currentleak/243-436-PCB-Support-STM32F407/README.md

# 243-436-PCB-Support-STM32F407

## PCB Support pour kit de développement STM32F407 Discovery 1

- Interface LCD 5V -- KS0108 ou LCD 12864
- Interface MikroBus (2)
- Interface PMOD -- GPIO -- I2C -- SPI -- UART
- Entrée Alimentation externe 5V
- Connecteur USB-C : Entrée 5V et USB à UART
