currentleak/243-436-PCB-Support-STM32F407/PDF/Report Board Stack.PDF

Layer | Board Layer Stack | Name | Material | Thickness Constant
1 | | Top Overlay | | 0mm
2 | | Top Solder | SM-001 | 0.0254mm | 4
3 | | Top Surface Finish | PbSn | 0.02mm
4 | | Top Layer | CF-004 | 0.035mm
5 | | Dielectric 1 | PP-017 | 0.12954mm | 4.3
6 | | Dielectric 2 | PP-017 | 0.12954mm | 4.3
7 | | Int1 (GND) | CF-004 | 0.035mm
8 | | Dielectric 3 | Core-039 | 0.7112mm | 4.8
9 | | Int2 (PWR) | CF-004 | 0.035mm
10 | | Dielectric 4 | PP-017 | 0.12954mm | 4.3
11 | | Dielectric 5 | PP-017 | 0.12954mm | 4.3
12 | | Bottom Layer | CF-004 | 0.035mm
13 | | Bottom Surface Finish | PbSn | 0.02mm
14 | | Bottom Solder | SM-001 | 0.0254mm | 4
15 | | Bottom Overlay | | 0mm
| Height : 1.46016mm

# Board Stack Report

Stack Up | Layer Stack
