currentleak/243-436-PCB-Support-STM32F407/PDF/Electrical Rules Check.PDF

### Electrical Rules Check Report

Class | Document | Message Successful Compile for 243-436_PCB-Support-STM32F407.PrjPcb
samedi 28 févr. 2026 2:19:12 PM | Page 1 of 1
