currentleak/243-436-PCB-Support-STM32F407/Generate Files/BOM/243-436_PCB-Support-STM32F407.xlsx

LibRef | Comment | Quantity | Designator | Description | CEGEP | Code CEGEP | Localisation | Manufacturer 1 | Manufacturer Part Number 1 | Supplier 1 | Supplier Part Number 1 | Supplier 2 | Supplier Part Number 2 | Mounting Technology
CAP003 | Cap 4.7uF 0805 | 14 | C1, C5, C7, C12, C14, C16A, C16B, C17A, C17B, C18, C19, C20, C21, C25 | Capacitor type 1 | KCOND02SM |  |  | Taiyo Yuden | TMK212AB7475KG-T | LCSC | C163186 |  |  | SMT
CAP001 | Cap 100nF 0402 | 12 | C2, C3, C6, C8, C11, C13, C15, C22, C23A, C23B, C24A, C24B | Capacitor type 1 | KCOND01SM |  |  | Taiyo Yuden | UMK105B7104KV-FR | LCSC | C2167491 |  |  | SMT
CAP005 | Cap 100uF 1206 | 1 | C4 | Capacitor type 1 | KCOND04SM |  |  | Murata | GRM31CR61A107MEA8L | LCSC | C883598 |  |  | SMT
CAP020 | CAP CER 10uF 25V X5R 0805 | 2 | C9, C10 | Capacitor type 1 |  |  |  | Samsung | CL21A106KAYNNNE | LCSC | C15850 |  |  | SMT
D_BAT60 | BAT60JFILM | 5 | D1, D2, D3, D4, D5 | DIODE SCHOTTKY 10V 3A SOD323 |  |  |  | ST | BAT60JFILM | LCSC | C133103 |  |  | SMT
CONN-DC-JACK-2MM5 | 694106301002 | 1 | J1 | DC Barrel Connector 2.5mm |  |  |  | XKB Connection | DC-005-5A-2.5 | LCSC | C381115 |  |  | TH
CONN-100MIL-HDR-01X02 | 61300211121 | 1 | J2 | CONN HEADER 2POS 100MIL |  |  |  | Megastar | ZX-PZ2.54-1-2PZZ | LCSC | C7501260 |  |  | TH
IND001 | Ind 1UH 2.75A 51mOHM SMD | 1 | L1 | Inductor type 1 | KPTSO09 |  |  | Murata Electronics | LQH3NPN1R0MMEL | LCSC | C703777 |  |  | SMT
CONN-100MIL-SKT-01X06_RA | PPTC061LGBN-RC | 1 | P1 | CONN SOCKET 6pos 100mils Right Angle |  |  |  | Megastar | ZX-PM2.54-1-6PWZ | LCSC | C49326178 | Digikey | S5442-ND | TH
CONN-100MIL-SKT-01X02 | ZX-PM2.54-1-2PY | 2 | P2, P3 | CONN SOCKET 2pins single row , 100mils TH |  |  |  | Megastar | ZX-PM2.54-1-2PY | LCSC | C7499322 |  |  | TH
CONN-100MIL-SKT-02X25 | ZX-PM2.54-2-25PY | 2 | P4, P5 | CONN SOCKET 2x25POS, Dual row 100MIL |  |  |  | Megastar | ZX-PM2.54-2-25PY | LCSC | C7499355 | Digikey | S9201-ND | TH
CONN-USB-C-16POS | USB4085-GF-A | 1 | P6 | CONN RCPT USB2.0 TYPE C RA - TH |  | ? (R13-B182) |  | Global Connector Technology | USB4085-GF-A | LCSC | C7095263 | Digikey | 2073-USB4085-GF-ACT-ND | TH
CONN-5MM-2POS-TERM-BLOCK | ZX-DG28V-5.0-2P | 1 | P7 | CONN TERM BLOCK 2POS 5mm pitch |  | CONWECO0002 |  | Megastar | ZX-DG28V-5.0-2P | LCSC | C49022995 |  |  | TH
CONN-100MIL-SKT-01X06 | ZX-PM2.54-1-6PY | 5 | P9, P10, P11, P12, P13 | CONN SOCKET 6pos 100mils |  |  |  | Megastar | ZX-PM2.54-1-6PY | LCSC | C7499326 |  |  | TH
CONN-5MM-3POS-TERM-BLOCK | ZX-DG28V-5.0-3P | 1 | P14 | CONN TERM BLOCK 3POS 5mm pitch |  | CONWECO0003 |  | Megastar | ZX-DG28V-5.0-3P | LCSC | ZX-DG28V-5.0-3P |  |  | TH
CONN-100MIL-SKT-01X08 | ZX-PM2.54-1-8PY | 4 | P14A, P14B, P15A, P15B | CONN SOCKET 8pos 100mils |  |  |  | Megastar | ZX-PM2.54-1-8PY | LCSC | C7499328 |  |  | TH
CONN-100MIL-SKT-01X20 | ESQ-120-14-G-S | 1 | P15 | CONN SOCKET 20POS 2.54MM |  | KCONDIV0053 | R13-B035 | Megastar | ZX-PM2.54-1-20PY | LCSC | C7499336 |  |  | TH
RES005 | Res 0R 0402 | 6 | R3, R4, R8, R10, R11, R12 | Resistor type 1 |  |  |  | Yageo | RC0402JR-070RL | LCSC | C60485 |  |  | SMT
RES010 | Res 5k1 1% 0402 | 3 | R7, R13, R14 | Resistor type 1 |  |  |  | Panasonic | ERJ-2RKF5101X | LCSC | C25905 |  |  | SMT
RES003 | Res 10k 1% 0402 | 4 | R9, R18, R19, R21 | Resistor type 1 |  |  |  | Vishay | CR0402F1002T1LF | Digikey | 541-10.0KLCT-ND |  |  | SMT
RES011 | Res 91k 1% 0402 | 1 | R16 | Resistor type 1 |  | RES91KSM |  | Yageo | RC0402FR-0791KL | LCSC | C327323 |  |  | SMT
RES012 | Res 511k 1% 0402 | 1 | R17 | Resistor type 1 |  | RES511KSM |  | Yageo | RC0402FR-07511KL | LCSC | C163461 |  |  | SMT
RES014 | Res 120R 1206 | 1 | R20 | Resistor type 1 | RESI0043SMT |  |  | Yageo | RC1206FR-07120RL | LCSC | C114928 | Digikey | P120ECT-ND | SMT
RES020 | Res 20R 1206 | 1 | R22 | Resistor type 1 | RESI00020SMT |  |  | Yageo | RC1206FR-0720RL | LCSC | C114941 |  |  | SMT
RES026 | Res 49k9 1% 0402 | 1 | R23 | Resistor type 1 |  |  |  | Yageo | RC0402FR-0749k9L | LCSC | C137969 |  |  | SMT
U_CH340X | CH340X | 1 | U1 | IC USB to Serial Port |  | KPTSO02 |  | WCH(Jiangsu Qin Heng) | CH340X | LCSC | C3035748 |  |  | SMT
U_TPD4E05U06 | TPD4E05U06QDQARQ1 | 1 | U2 | TVS DIODE 5.5V 14V 10USON |  |  |  | Texas Instruments | TPD4E05U06QDQARQ1 | LCSC | C81353 | Digikey | 296-40696-1-ND | SMT
U_TPS631000DRLR | TPS631000DRLR | 1 | U3 | buck-boost converter 1.5-A output current, |  |  |  | Texas Instruments | TPS631000DRLR | LCSC | C5219190 | Digikey | 296-TPS631000DRLRCT-ND | SMT
U_SN65HVD230DR | SN65HVD230DR | 1 | U4 | IC TRANSCEIVER HALF 1/1 8SOIC |  |  |  | TI | SN65HVD230DR | LCSC | C12084 |  |  | SMT
U_TXB0108PWR | TXB0108PWR | 2 | U5A, U5B | IC 8-Bit Bidirectional Voltage-Level Translator with Auto-Direction Sensing 20-Pin TSSOP (PW) |  |  |  | Texas Instruments | TXB0108PWR | LCSC | C53406 |  |  | SMT
RP-POT10K-MULTI-TURN-TOP-TH | 3296W-1-103LF | 1 | VR1 | TRIMMER 10K OHM 0.5W PC PIN TOP |  |  |  | JIERR | 3296W-1-103LF | LCSC | C49190453 | LCSC | C34846 | TH
