currentleak/243-436-PCB-Support-STM32F407/Generate Files/AutoCAD PCB/243-436_PCB-Support-STM32F407.DXF

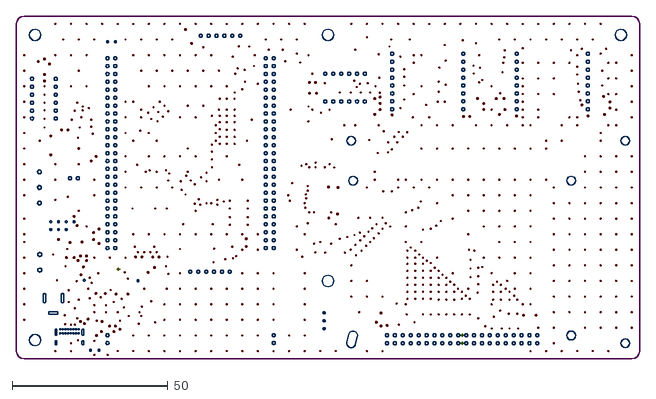
[picture p1: CAD file, 2026-02-28]
Generate Files/AutoCAD PCB/243-436_PCB-Support-STM32F407.DXF
200.0 x 110.0
