currentleak/243-436-PCB-Support-STM32F407/PDF/Schematic Prints.PDF

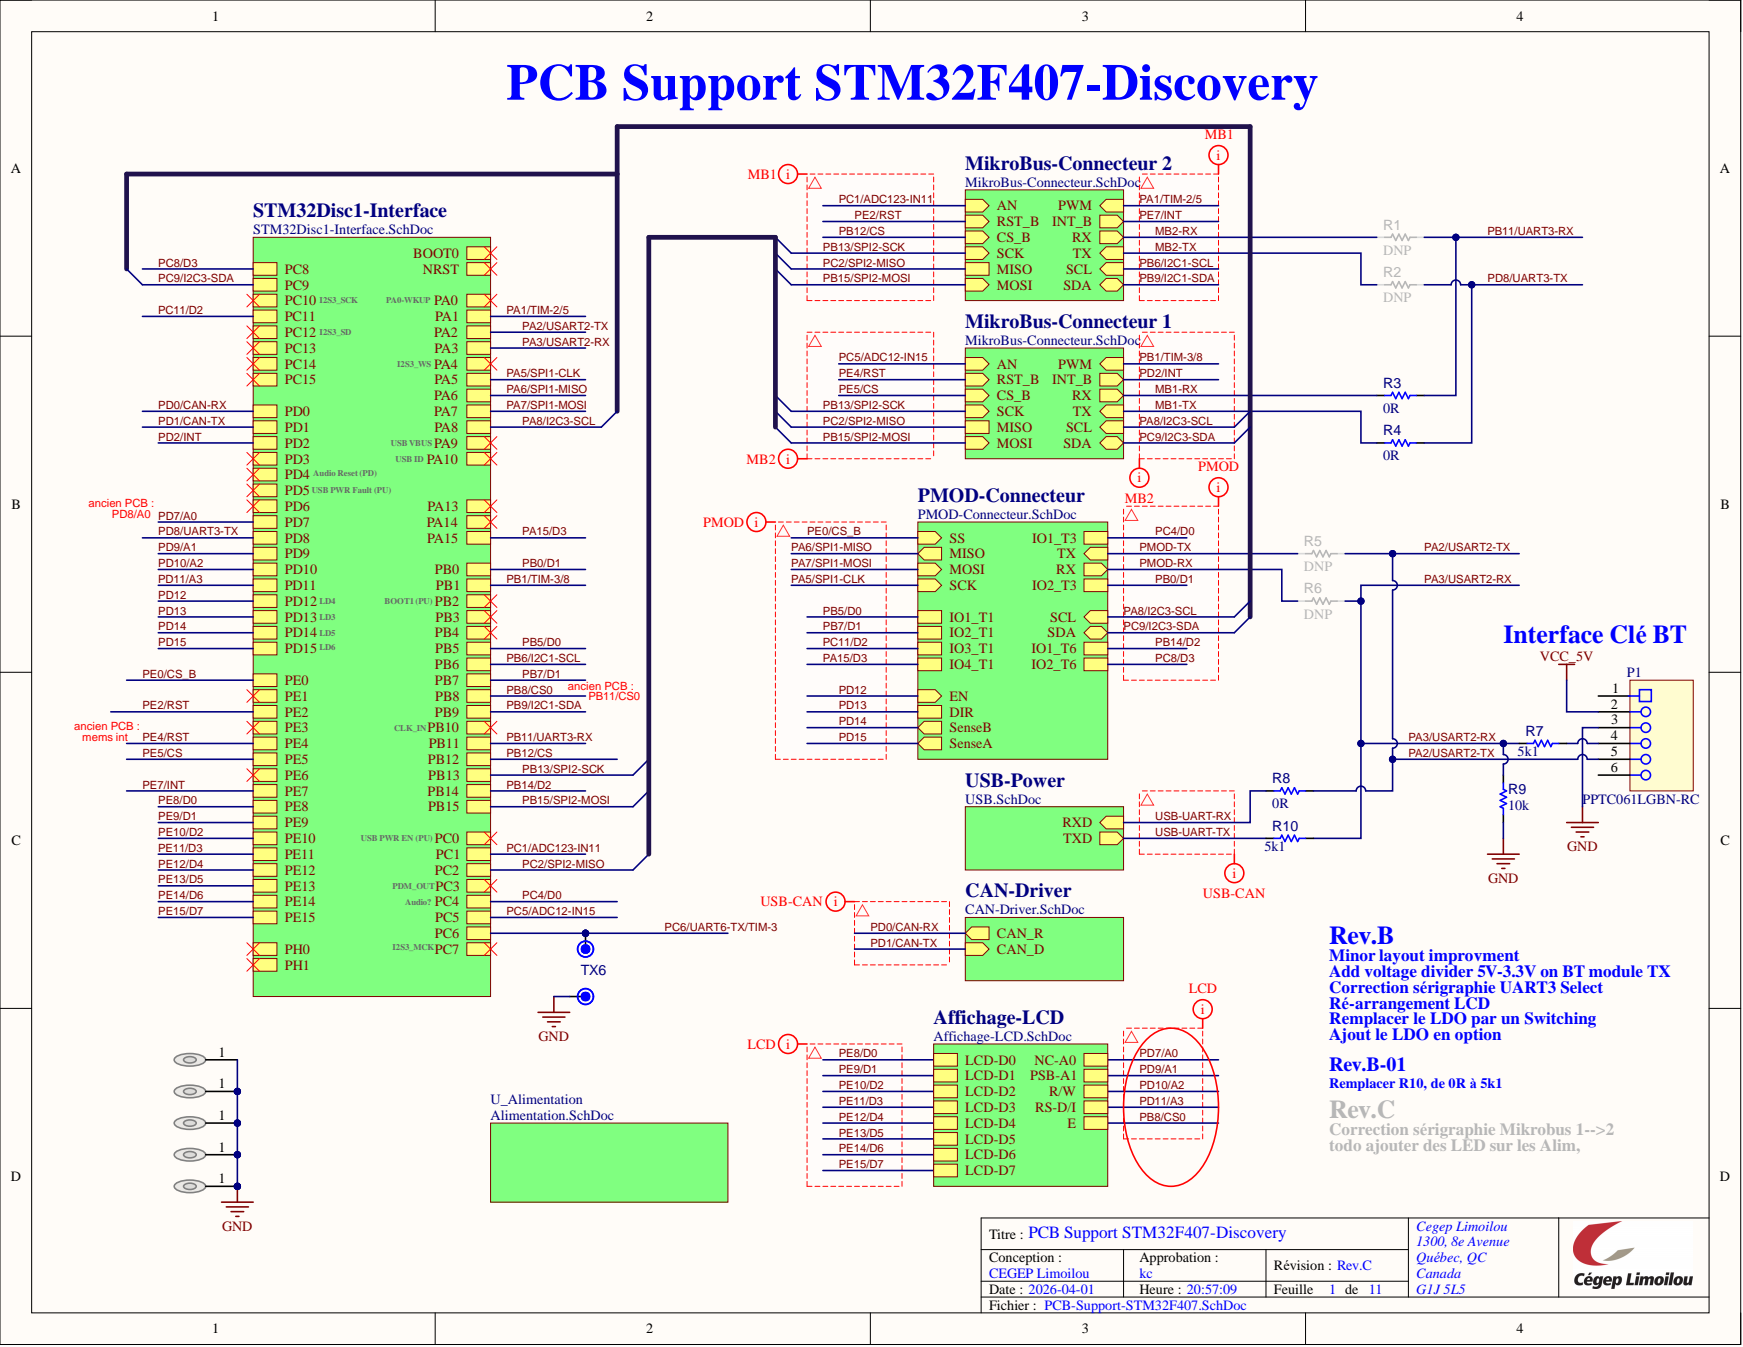
[picture p2: page 1]

PCB Support STM32F407-Discovery PA1/TIM-2/5

PE7/IN T
MB2-R X
MB2-TX
PB6/I2C1-SC L
PB9/I2C1-SD A

USB-Power USB.SchDoc

USB PWR EN (PU)

CAN-Driver CAN-Driver.SchDoc

Rev.B
Minor layout improvment
Add voltage divider 5V-3.3V on BT
Correction
é-arrangement LCD
Remplacer le LDO par un Switching
Ajout le LDO en option
Rev.B-0
Remplacer R10, de 0R
Rev.C
todo ajouter des LED sur les Alim

PD9/A 1
PD10/A 2
PD11/A 3
PB8/CS 0

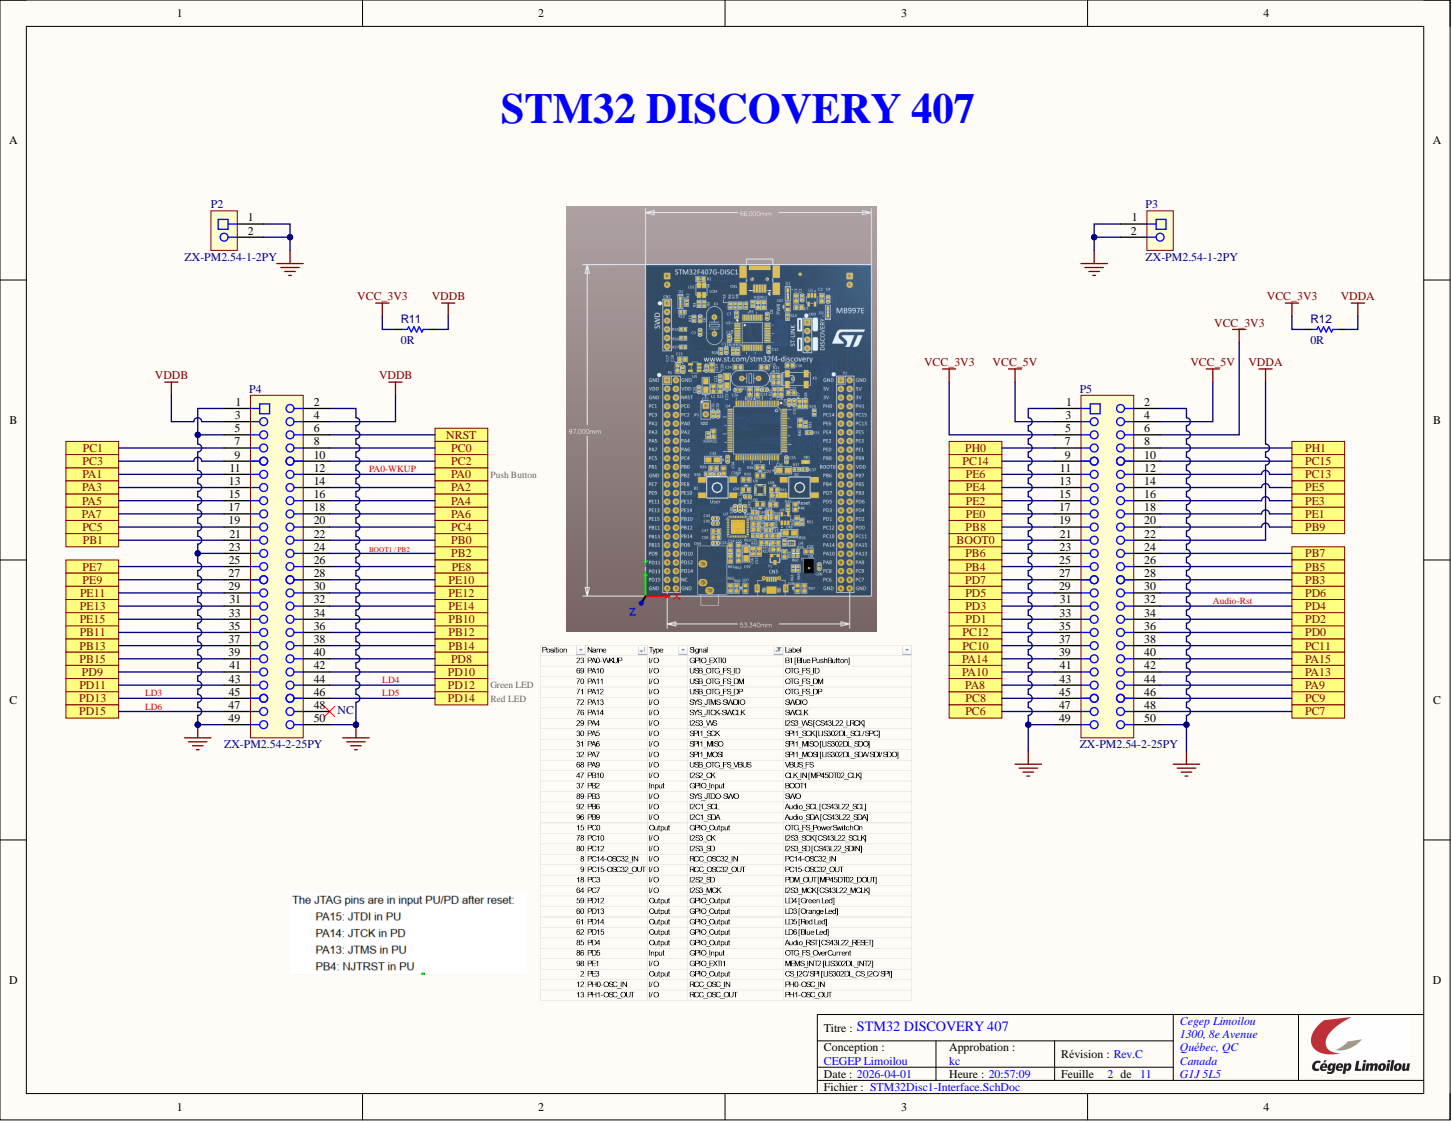
[picture p3: page 2]

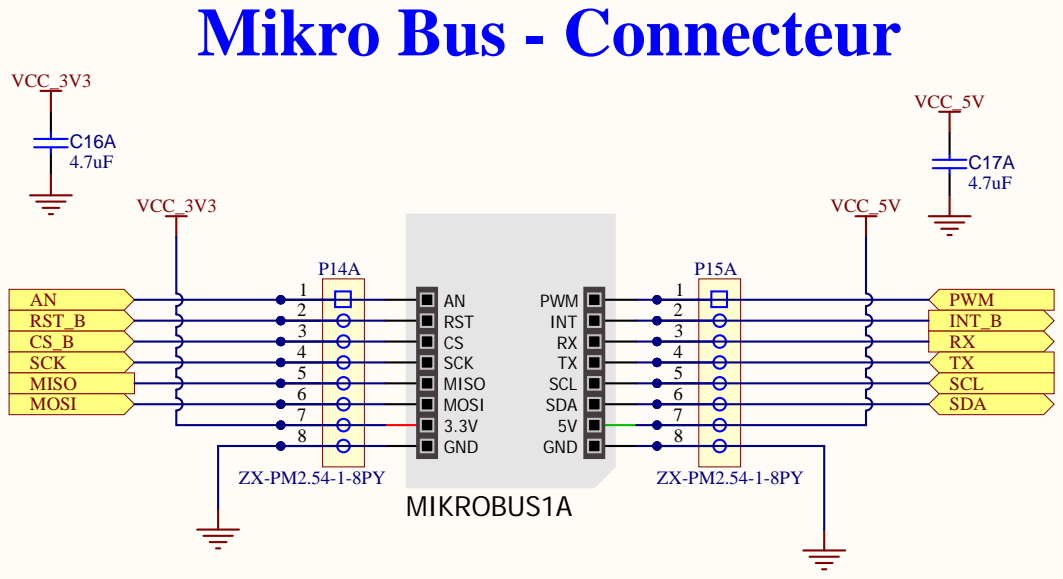
[picture p4: page 3]

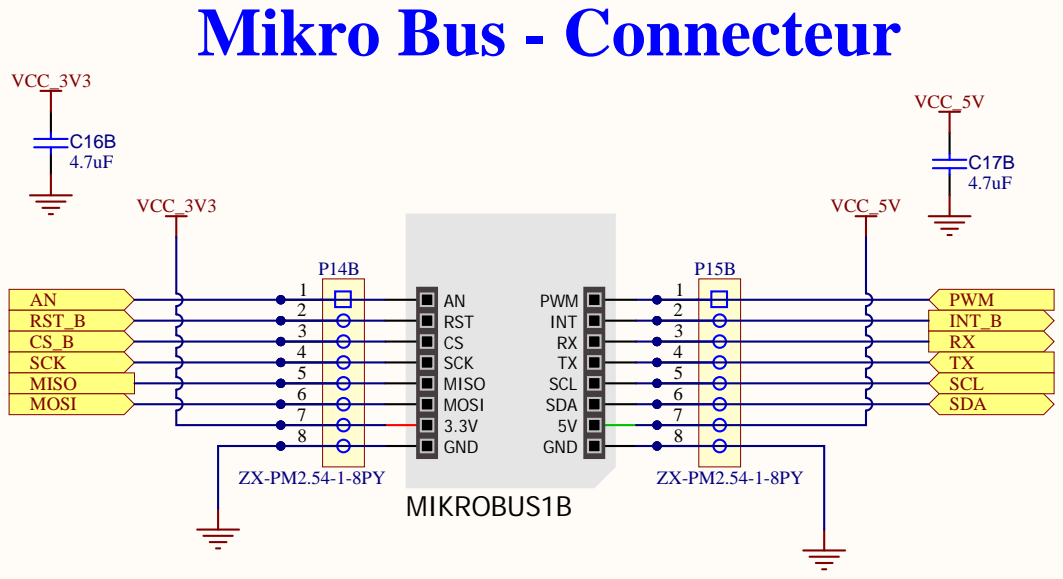
[picture p5: page 4]

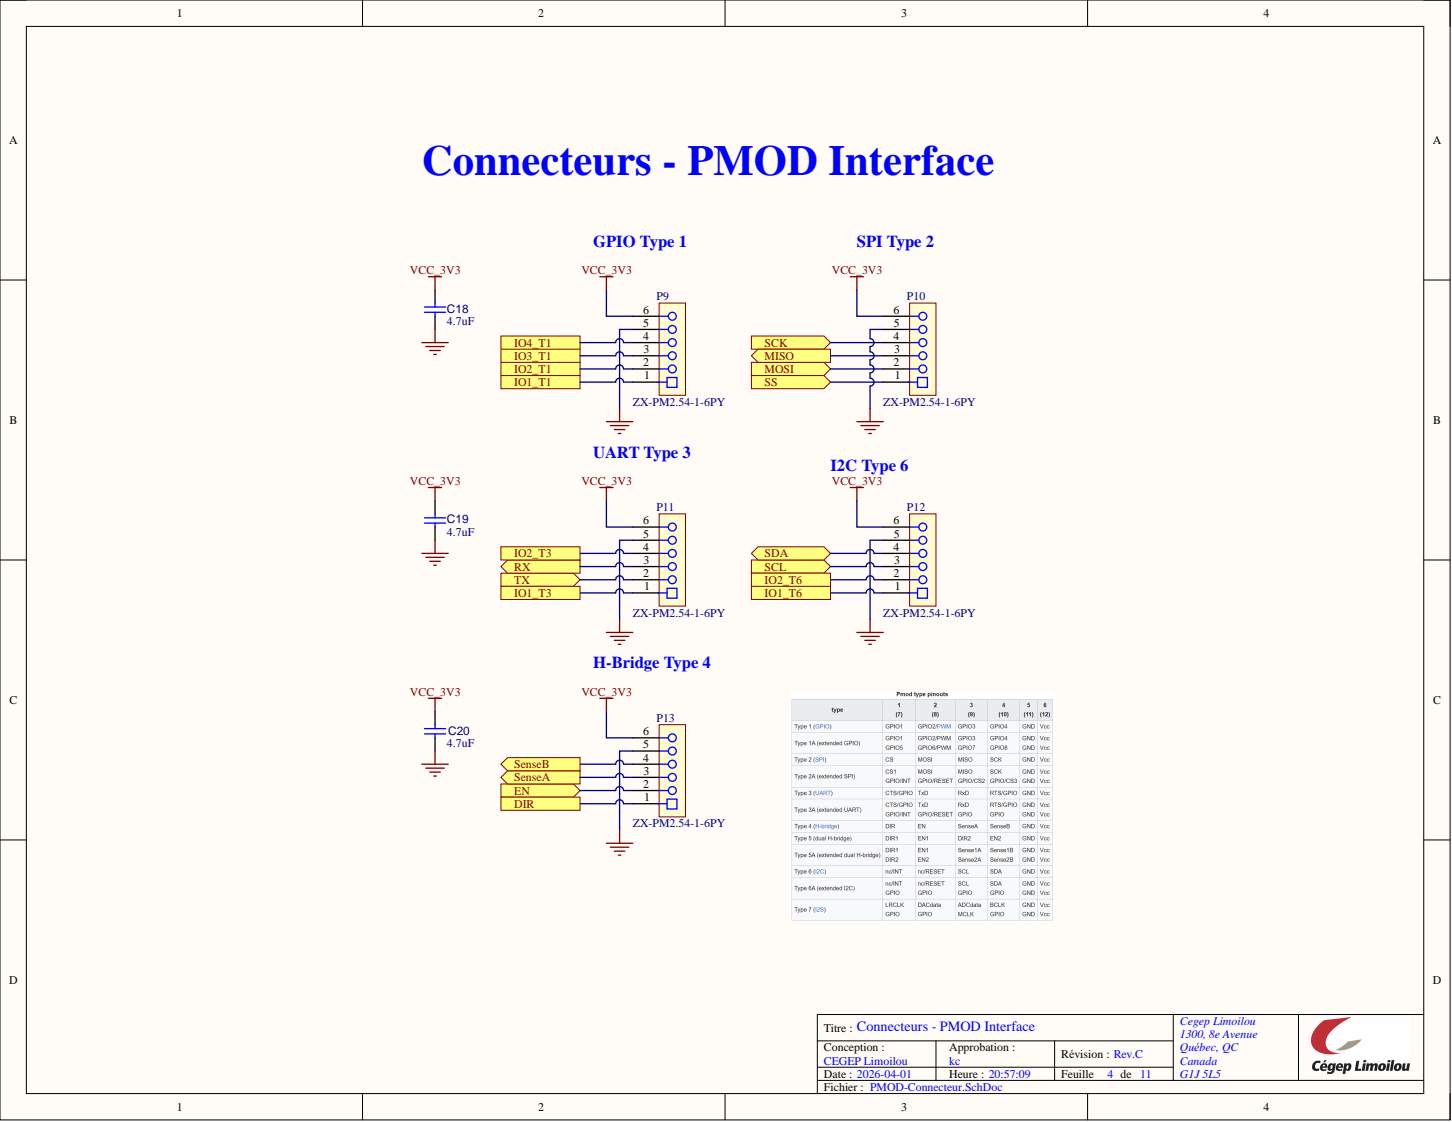
[picture p6: page 5]

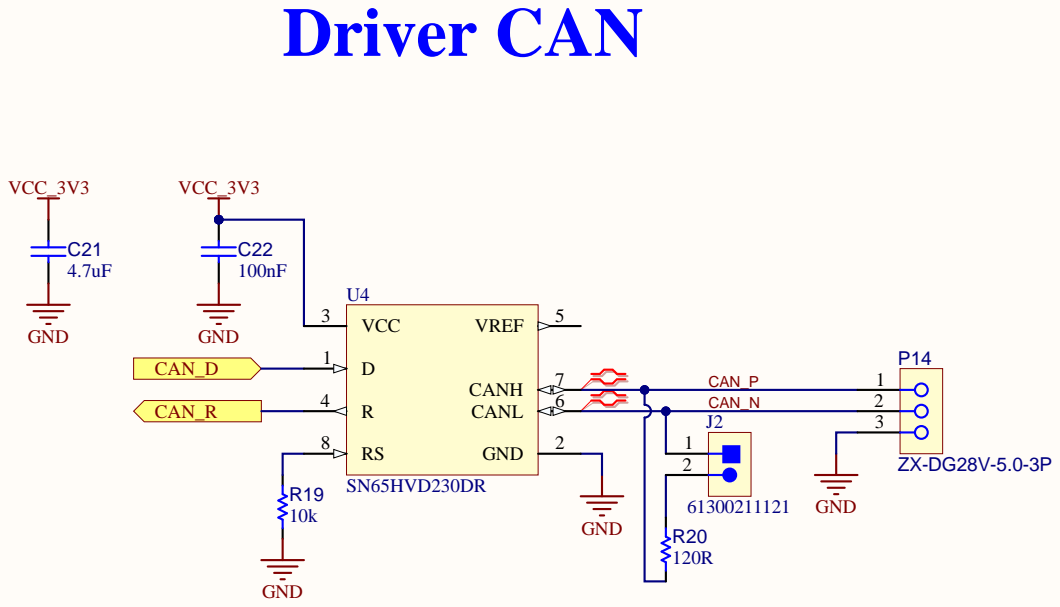
[picture p7: page 6]

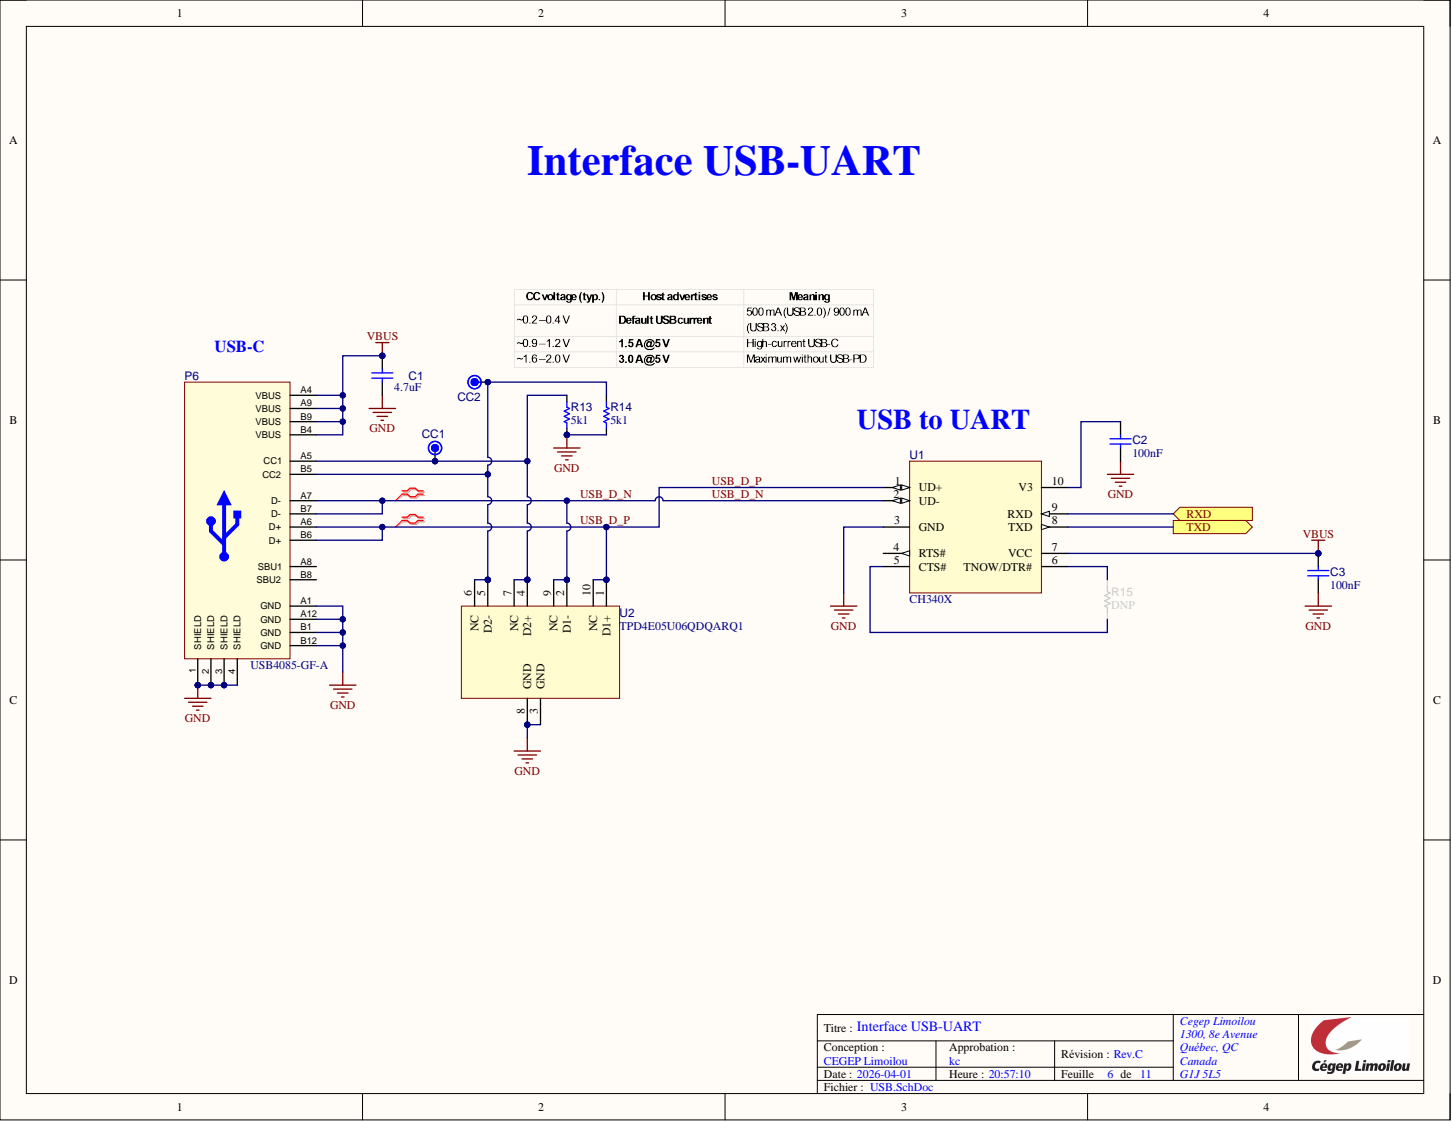
[picture p8: page 7]

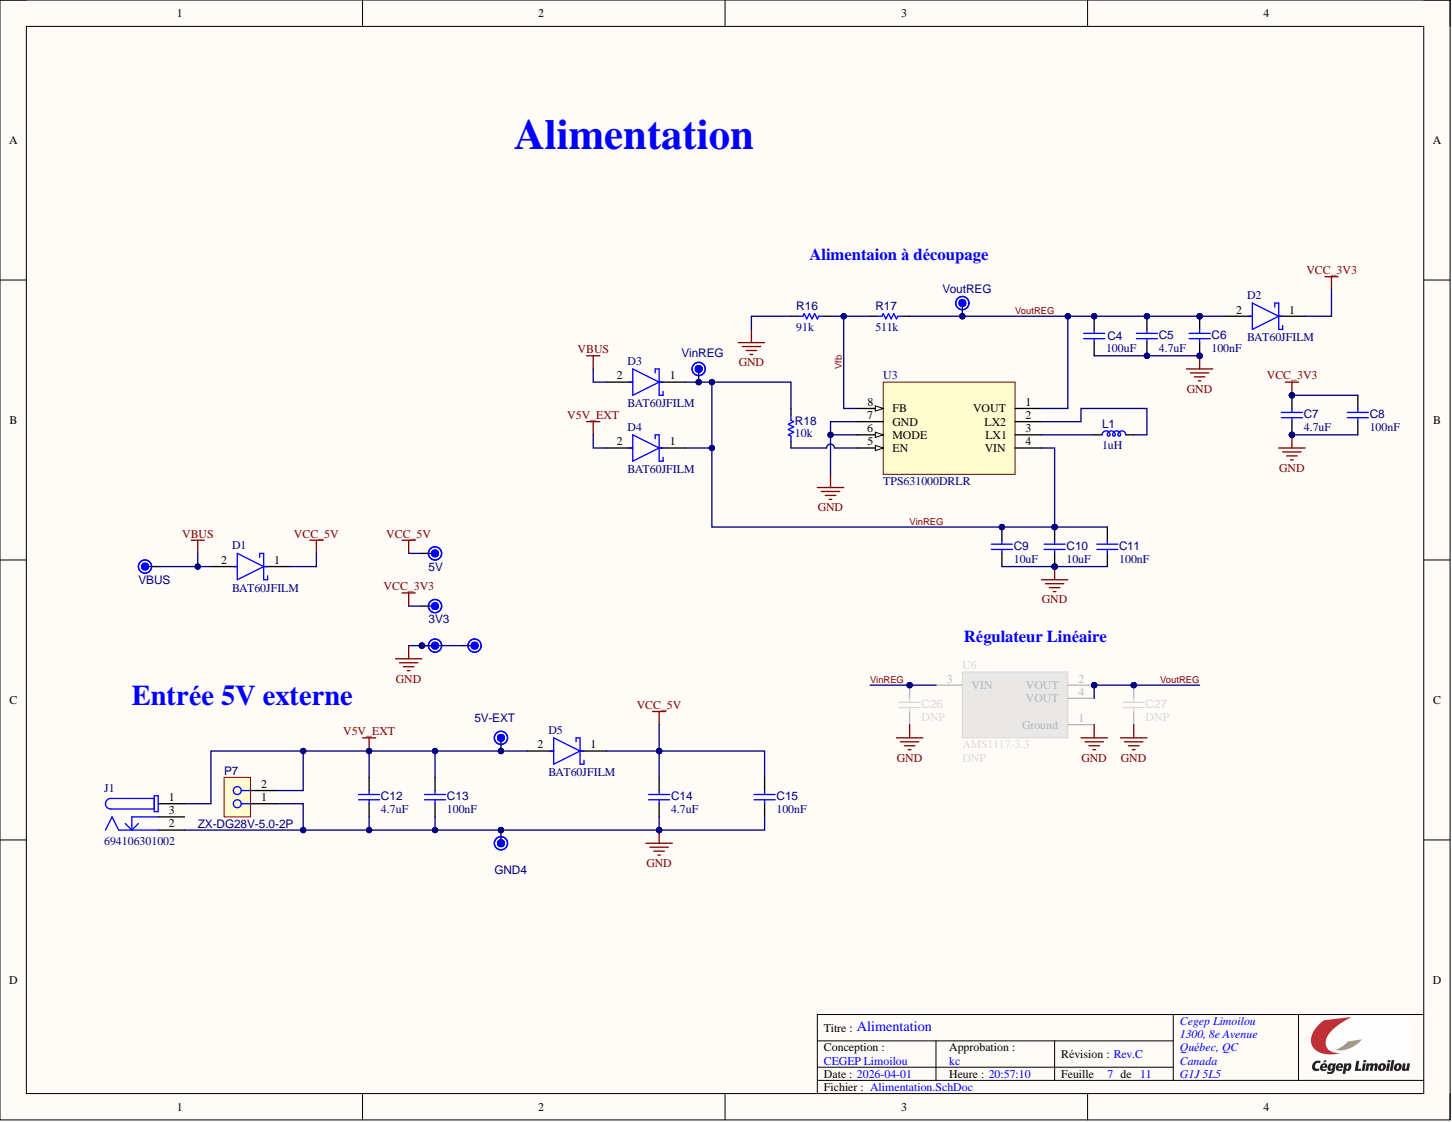
[picture p9: page 8]

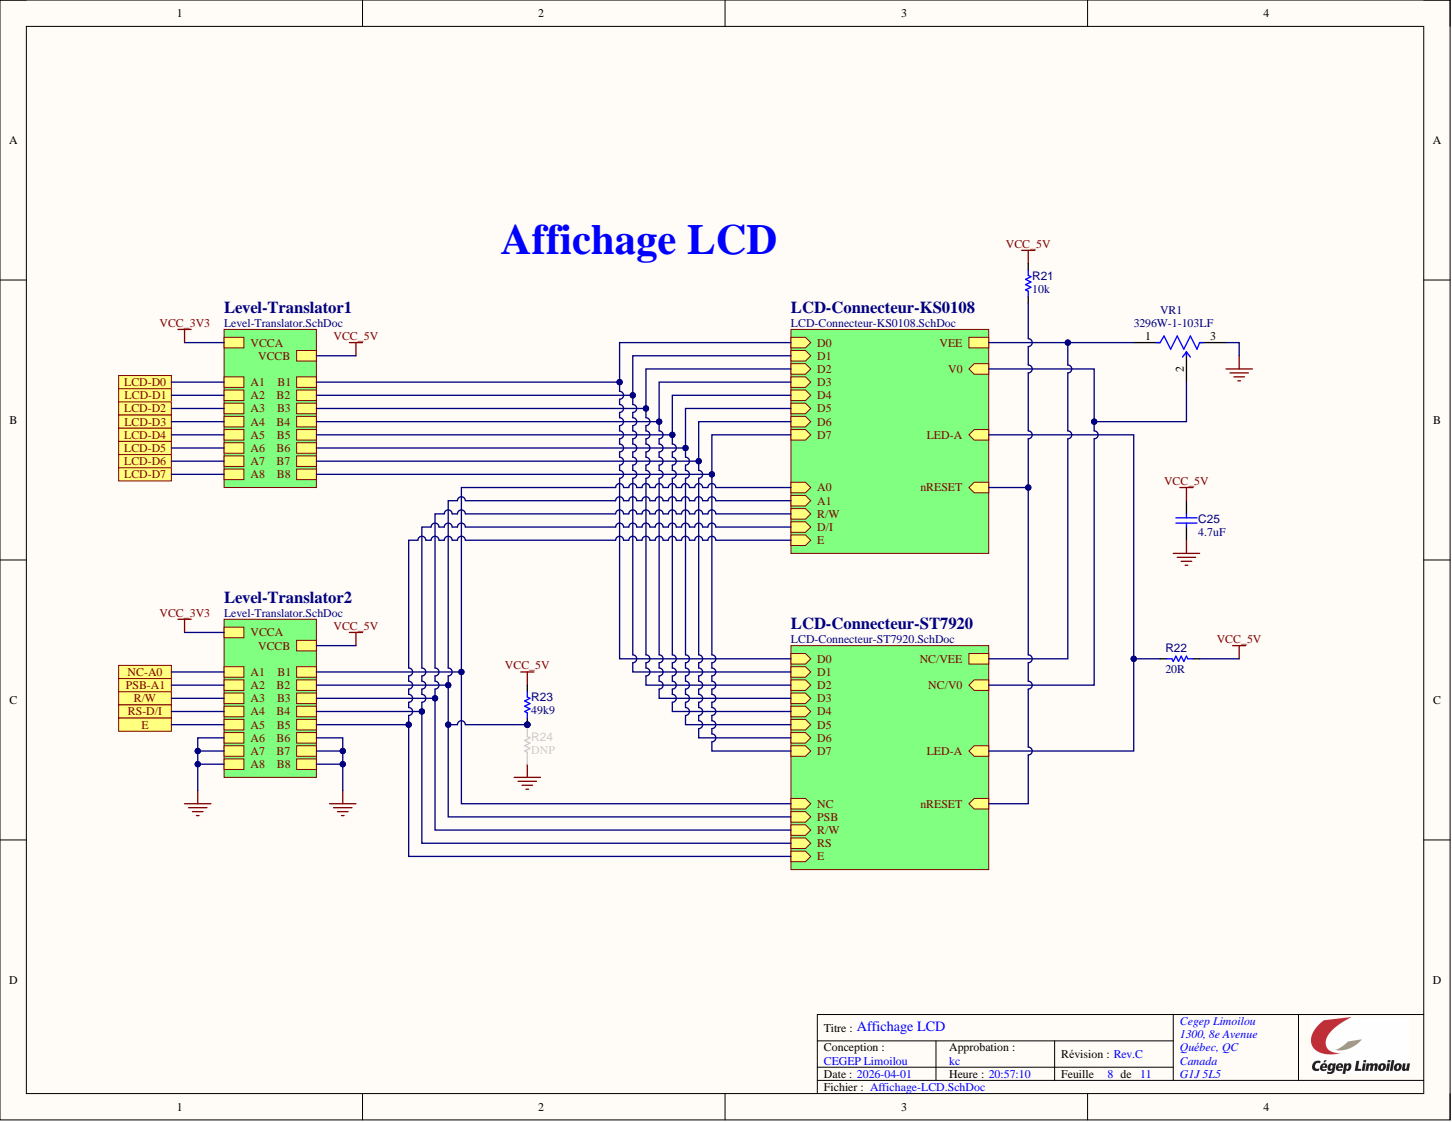
[picture p10: page 9]

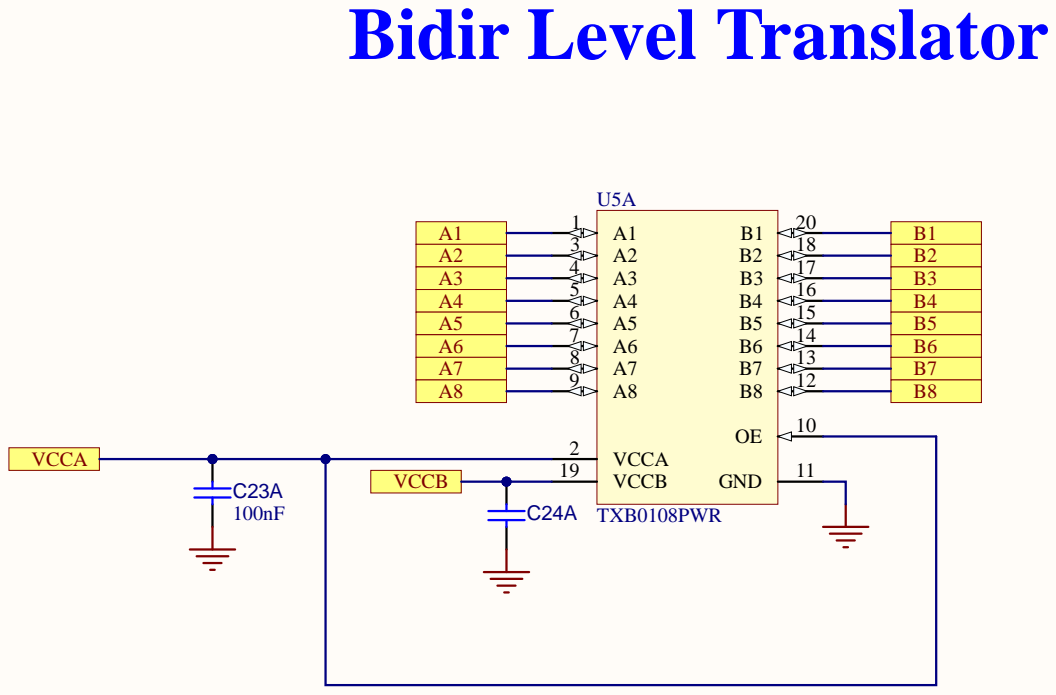
[picture p11: page 10]

A4 | B4
A5 | B5

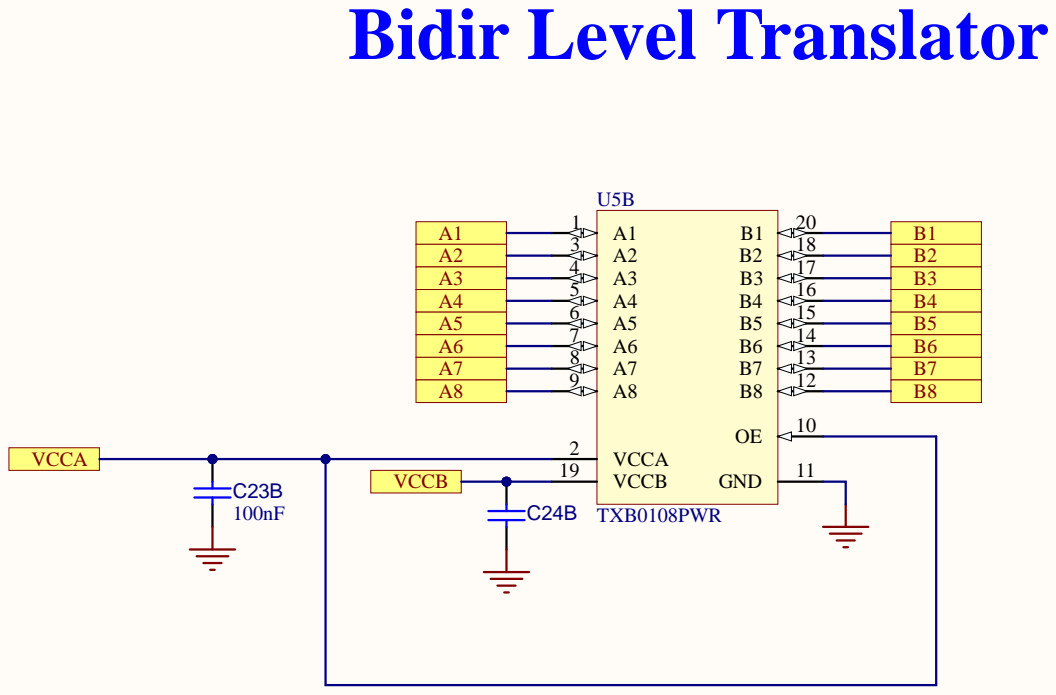
[picture p12: page 11]

A4 | B4
A5 | B5

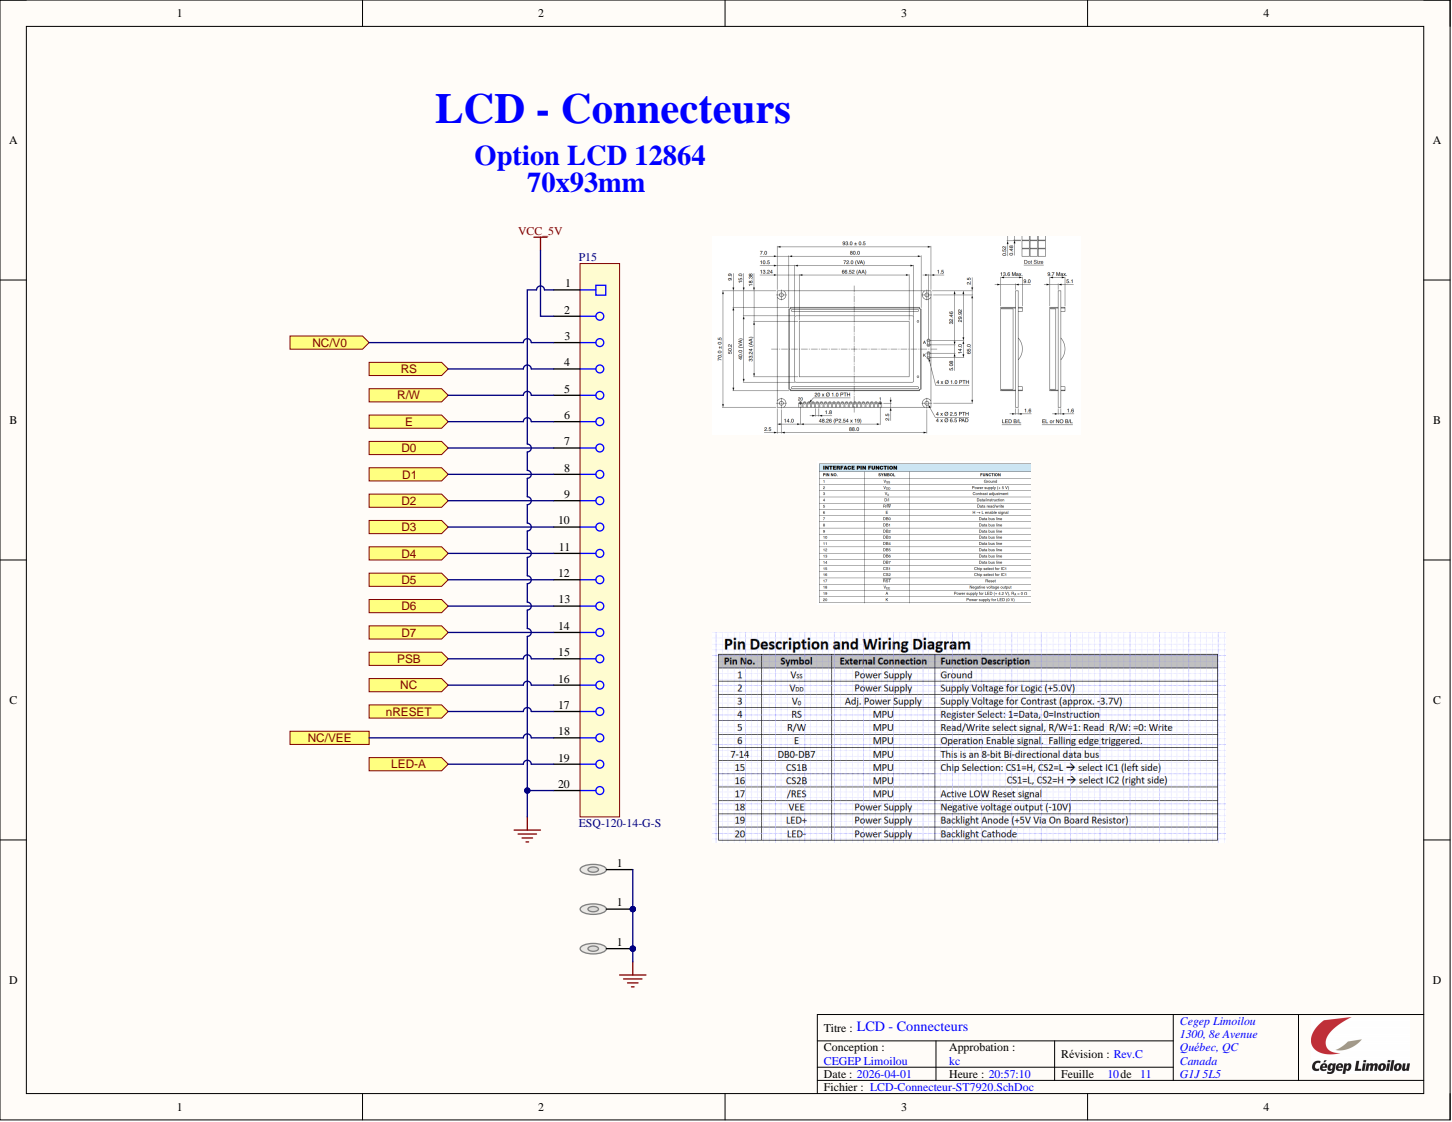
[picture p13: page 12]

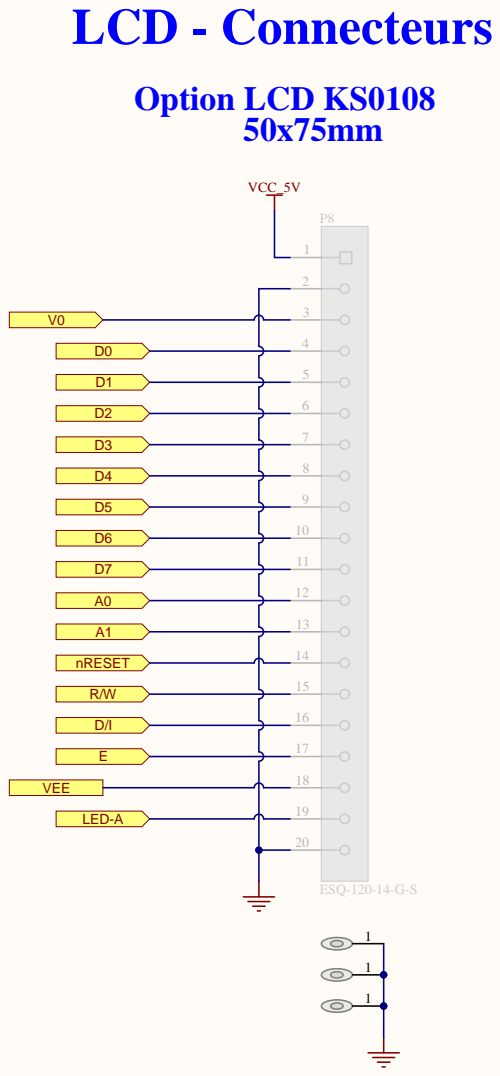
[picture p14: page 13]
