currentleak/243-436-PCB-Support-STM32F407/PDF/Assembly Drawings.PDF

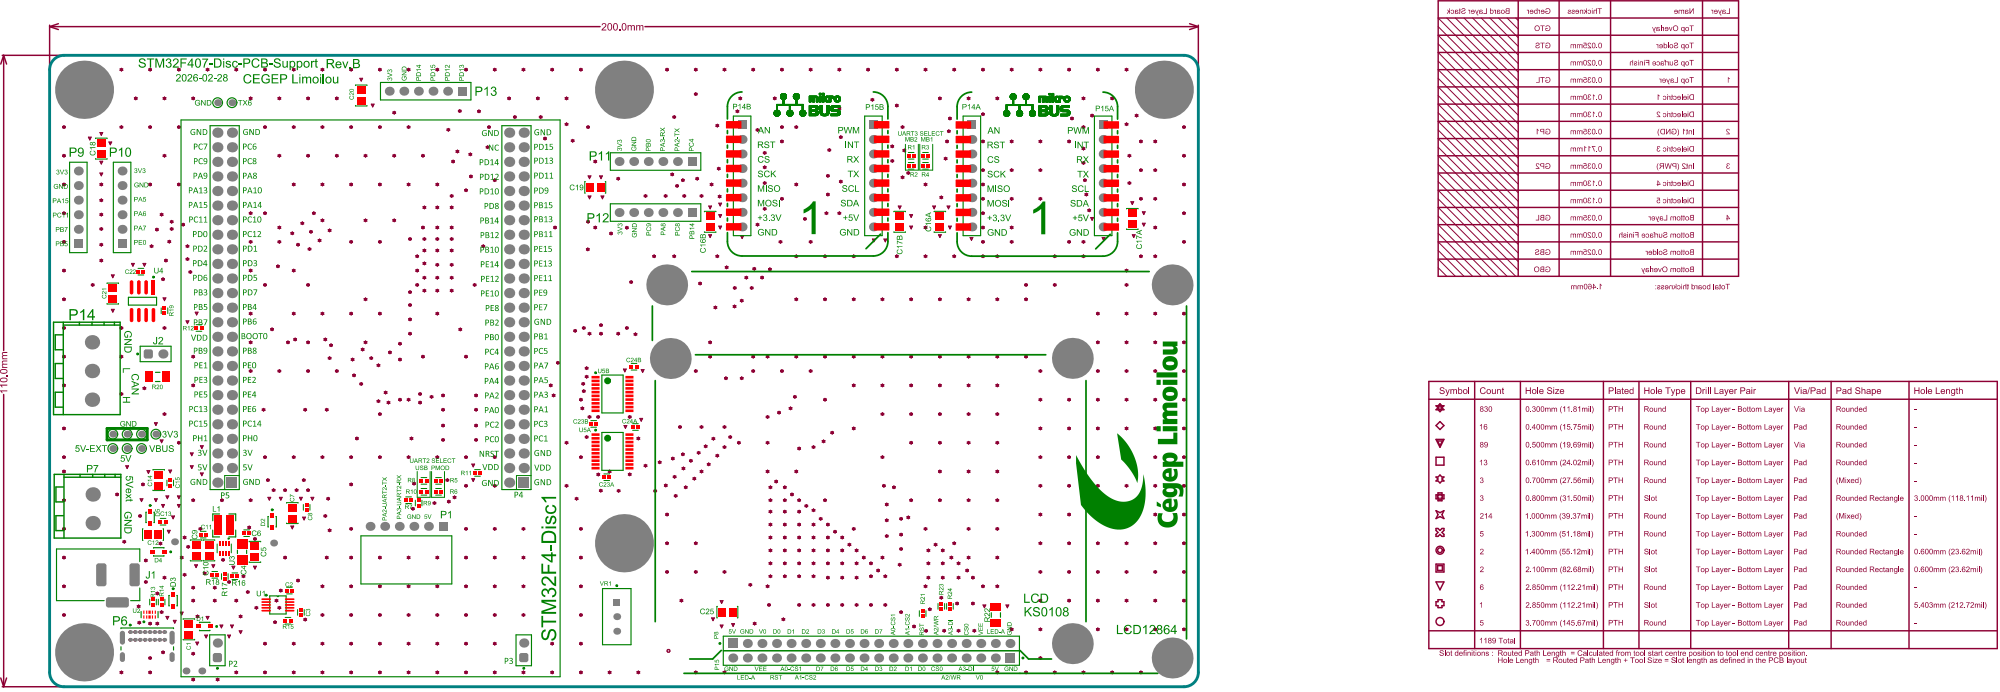
[picture p15: page 1]

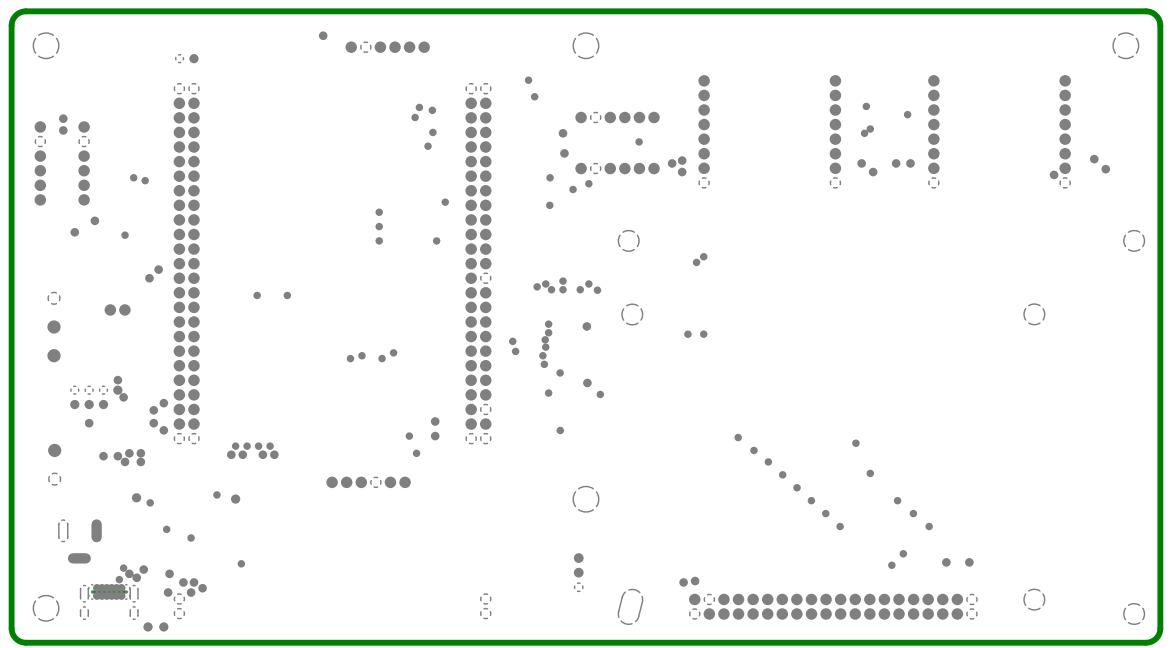
[picture p16: page 2]

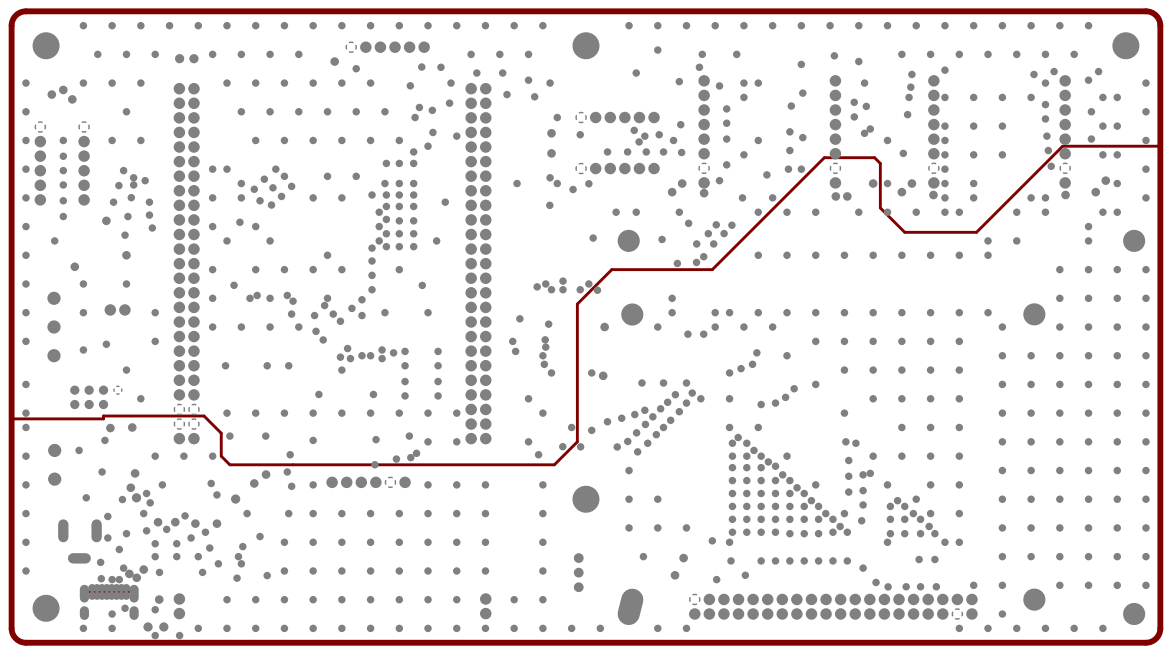
[picture p17: page 3]

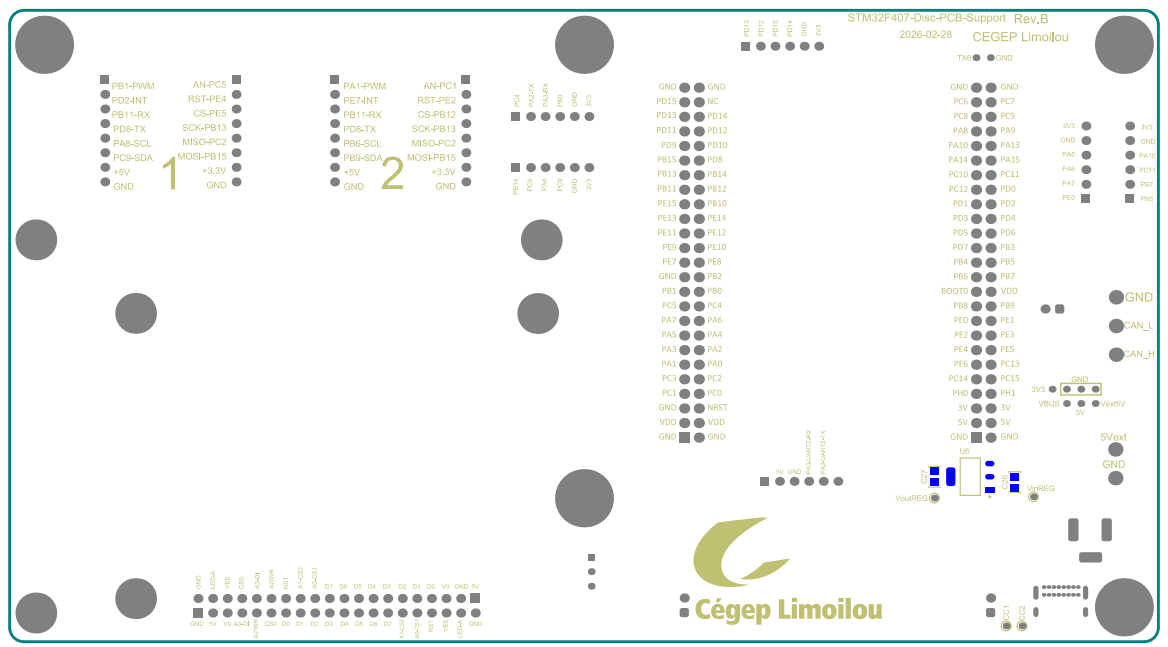
[picture p18: page 4]
