currentleak/243-436-PCB-Support-STM32F407/PDF/Design Rules Check.PDF

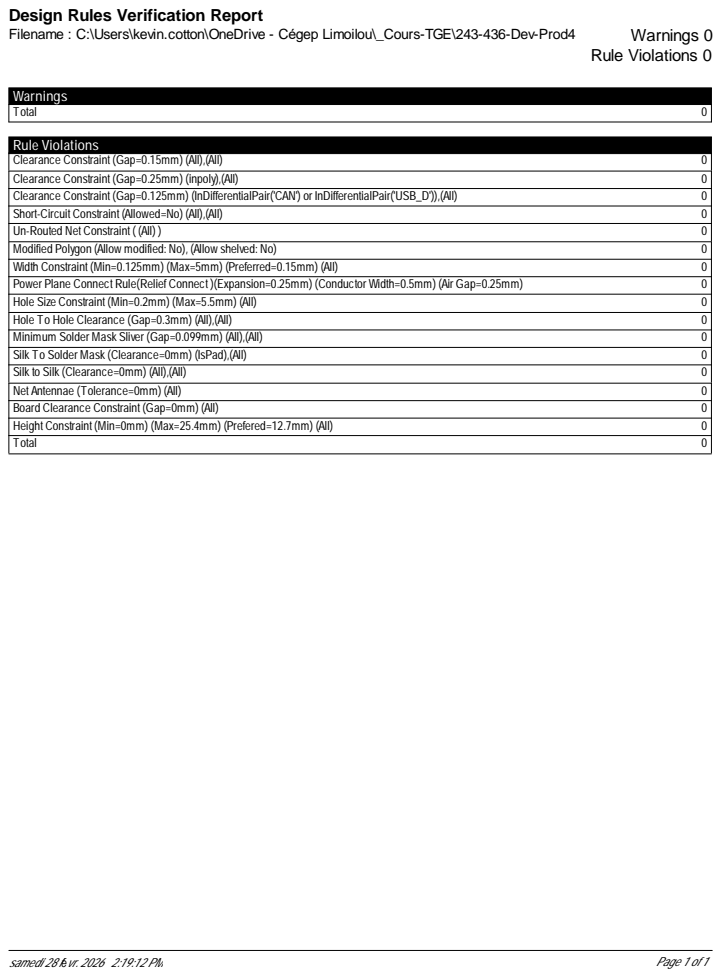
[picture p19: page 1]

Design Rules Verification Report
