currentleak/243-436-PCB-Support-STM32F407/PDF/PCB 3D Print bottom.PDF

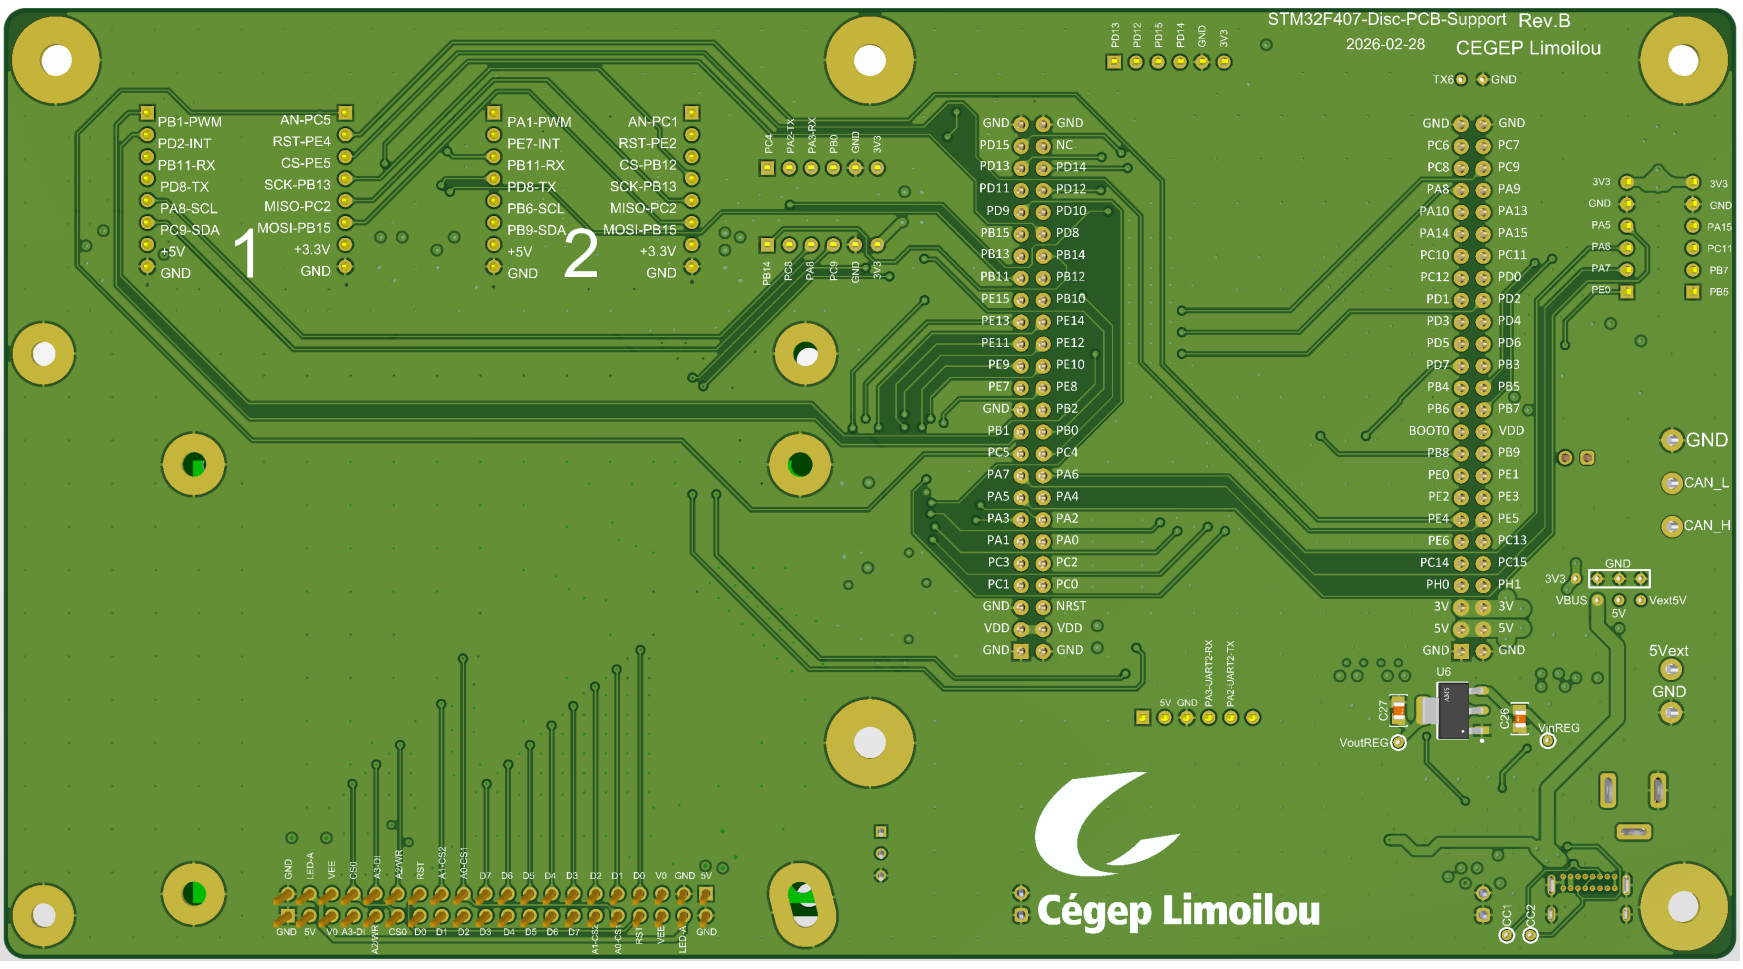
[picture p20: page 1]
