currentleak/243-436-PCB-Support-STM32F407/PDF/PCB 3D Print top.PDF

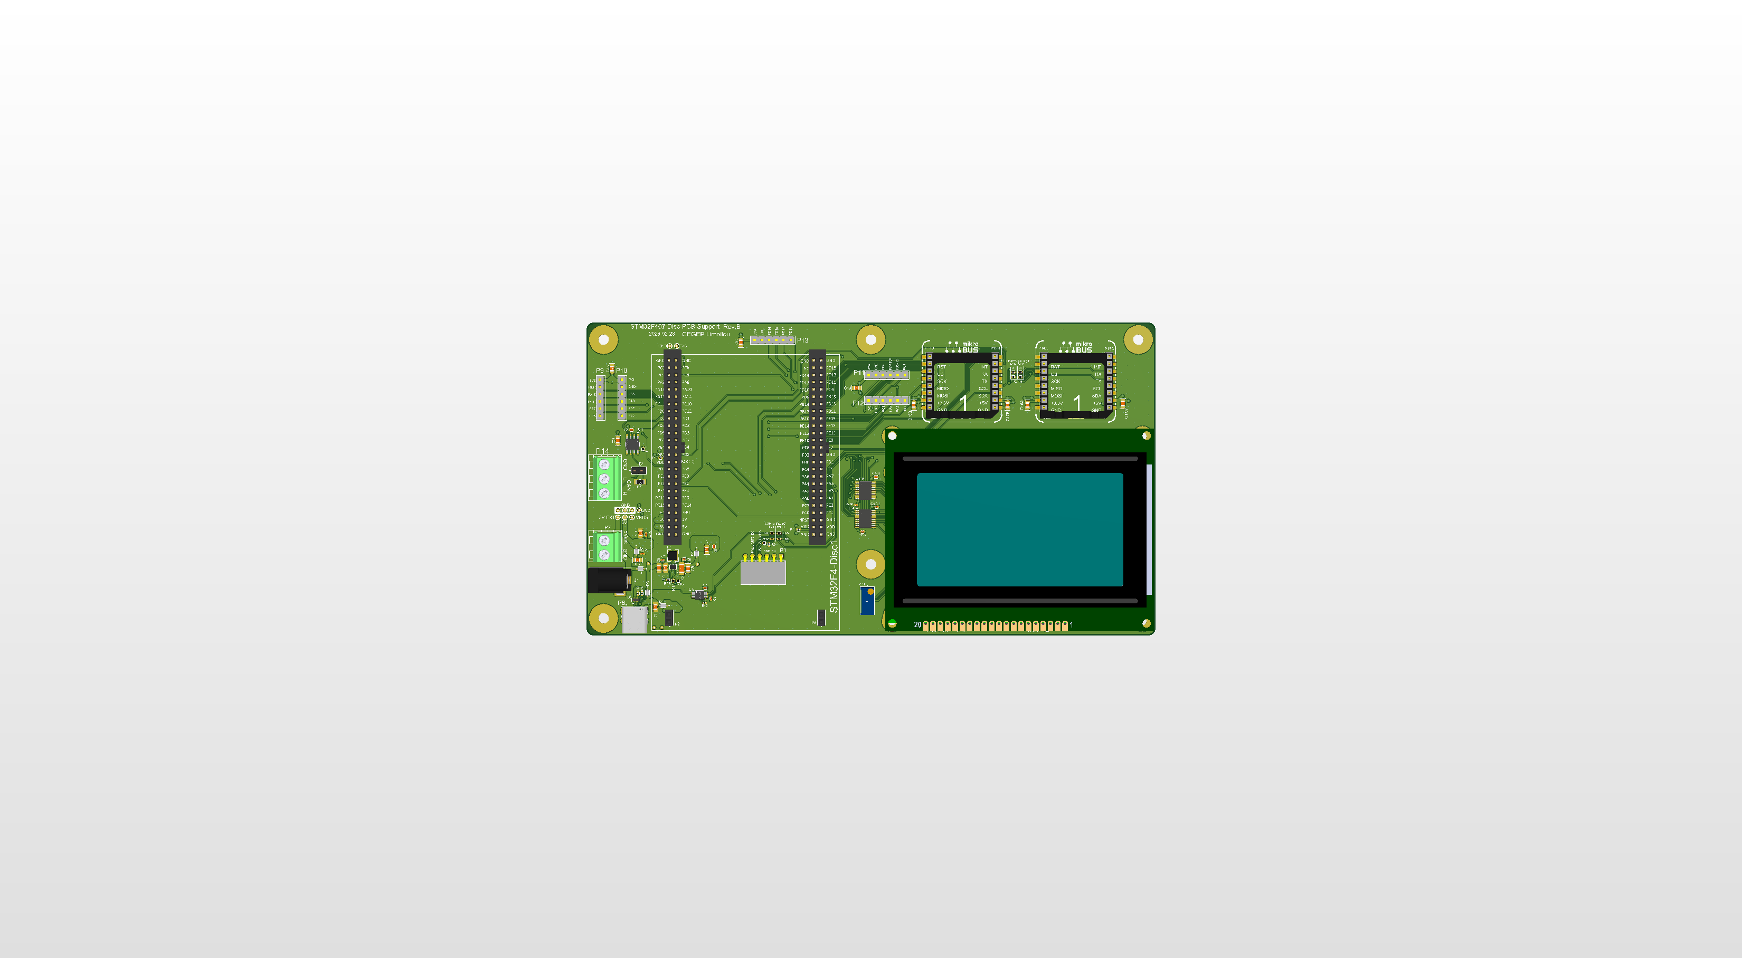
[picture p21: page 1]
