currentleak/243-436-PCB-Support-STM32F407/PDF/Drill Drawing.PDF

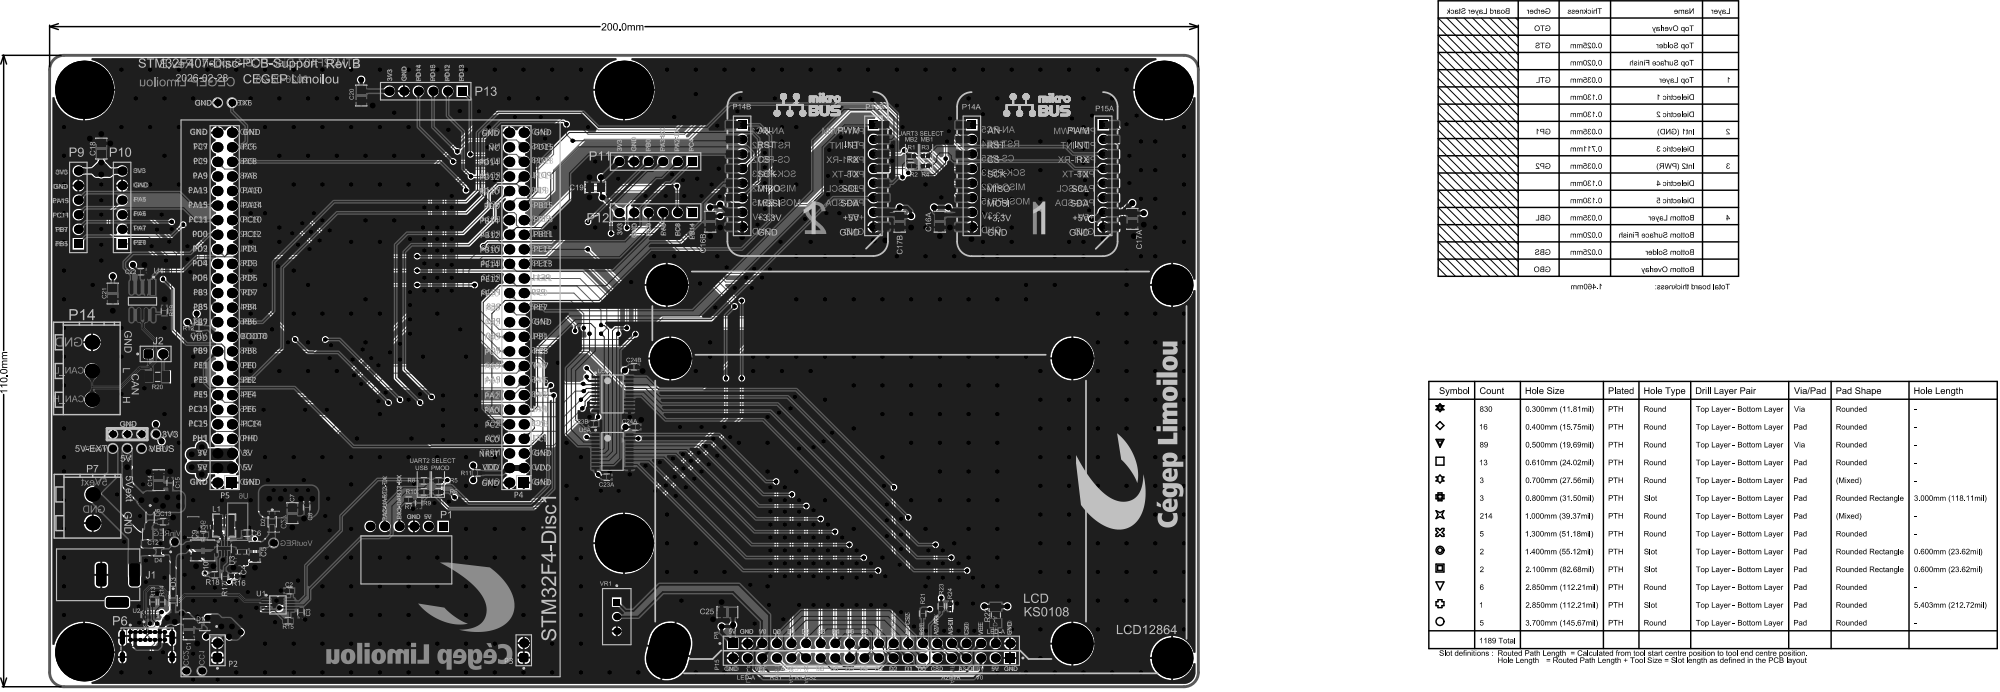
[picture p22: page 1]
