currentleak/243-436-PCB-Support-STM32F407/(list of files, drawings)

Other design files:
243-436_PCB-Support-STM32F407.PrjPcb
Affichage-LCD.SchDoc
Alimentation.SchDoc
CAN-Driver.SchDoc
LCD-Connecteur-KS0108.SchDoc
LCD-Connecteur-ST7920.SchDoc
Level-Translator.SchDoc
MikroBus-Connecteur.SchDoc
PCB-Support-STM32F407-2layers-polygon-EMI.PcbDoc
PCB-Support-STM32F407.PcbDoc
PCB-Support-STM32F407.SchDoc
PMOD-Connecteur.SchDoc
STM32Disc1-Interface.SchDoc
USB.SchDoc
