currentleak/243-436-PCB-Support-STM32F407/(commit log)

2026-01-04 first commit source files
    [CAN-Driver.SchDoc, LCD-Connecteur.SchDoc, MikroBus-Connecteur.SchDoc, PCB-Support-STM32F407.SchDoc, PMOD-Connecteur.SchDoc, STM32Disc1-Interface.SchDoc, USB.SchDoc]
2026-01-04 add generated files
    [243-436_PCB-Support-STM32F407.DXF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]
2026-01-07 as first order
    [243-436_PCB-Support-STM32F407.DXF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]
2026-02-02 wip revB
    [243-436_PCB-Support-STM32F407.DXF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]
2026-02-08 re-arrange Schematic
    [243-436_PCB-Support-STM32F407.PrjPcb, Affichage-LCD.SchDoc, LCD-Connecteur-KS0108.SchDoc, LCD-Connecteur-ST7920.SchDoc, LCD-Connecteur.SchDoc, Level-Translator.SchDoc, PCB-Support-STM32F407-version-2layers-only-test-EMI.PcbDoc, PCB-Support-STM32F407.PcbDoc]
2026-02-09 re-arrange LCD schematic
    [Affichage-LCD.SchDoc, LCD-Connecteur-ST7920.SchDoc, PCB-Support-STM32F407.SchDoc]
2026-02-25 add PCB version 2 layers no stitching via
    [243-436_PCB-Support-STM32F407.PrjPcb, 243-436_PCB-Support-STM32F407.xlsx, Affichage-LCD.SchDoc, CAN-Driver.SchDoc, LCD-Connecteur-KS0108.SchDoc, LCD-Connecteur-ST7920.SchDoc, Level-Translator.SchDoc, MikroBus-Connecteur.SchDoc]
2026-02-27 wip rev.B
    [243-436_PCB-Support-STM32F407.PrjPcb, PCB-Support-STM32F407.PcbDoc]
2026-02-27 order revB
    [243-436_PCB-Support-STM32F407.DXF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]
2026-02-28 add option LDO regulator on rev.B
    [243-436_PCB-Support-STM32F407.DXF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]
2026-04-02 RevB-01 and wip RevC
    [243-436_PCB-Support-STM32F407.PrjPcb, PCB-Support-STM32F407-2layers-polygon-EMI.PcbDoc, PCB-Support-STM32F407.PcbDoc, PCB-Support-STM32F407.SchDoc]
2026-04-12 wip rev.C
    [243-436_PCB-Support-STM32F407.PrjPcb, Alimentation.SchDoc, PCB-Support-STM32F407.SchDoc]
